Ithoh/OpenRucheDLCB/README.md

# OpenRucheDLCB

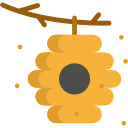
[picture p1: Ressources/hive.png]
GitHub Logo


Github participatif du projet open ruche polytech sorbonne Ei-2i-4

### **Arduino code depedencies :**

* Arduino Low Power
* Arduino SigFox for MKRFox1200
* RTCZero
* Adafruit Unified Sensor
* DallasTemperature
* DHT Sensor library
* OneWire
