Ithoh/OpenRucheDLCB/Documentation/Project_Connected_Beehive_v2.pptx

## Connected Beehive Project

DELAS Léo – DOS SANTOS Damien – DURAND DE GEVIGNEY Basile – TAN Caroline
EI2I 4 II

## Sommaire

- I - PCB Final
- II – Consommation du système
- III – Sigfox et Ubidots
- IV – Résultats
- V - Installation
- VI – Conclusion

## I - Diagramme Synoptique

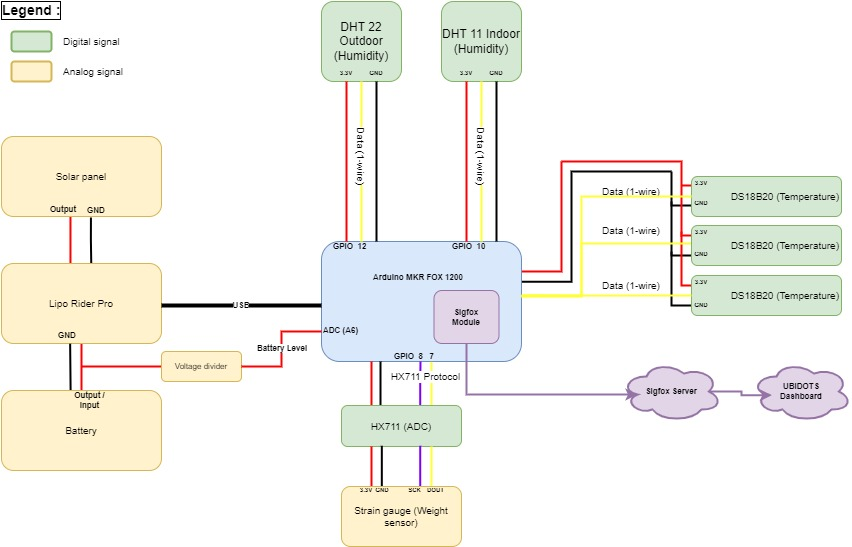
[picture p2: figure]

## I - PCB Final

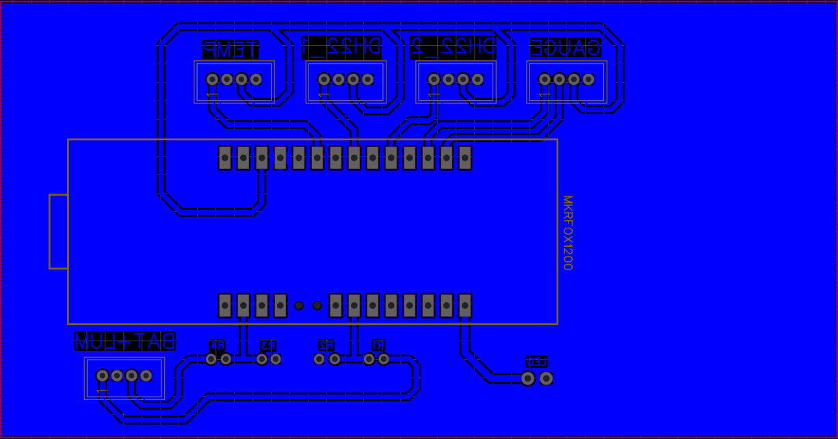
[picture p3: figure]

## II - Consommation du système

Mesures avec l’outil OTII

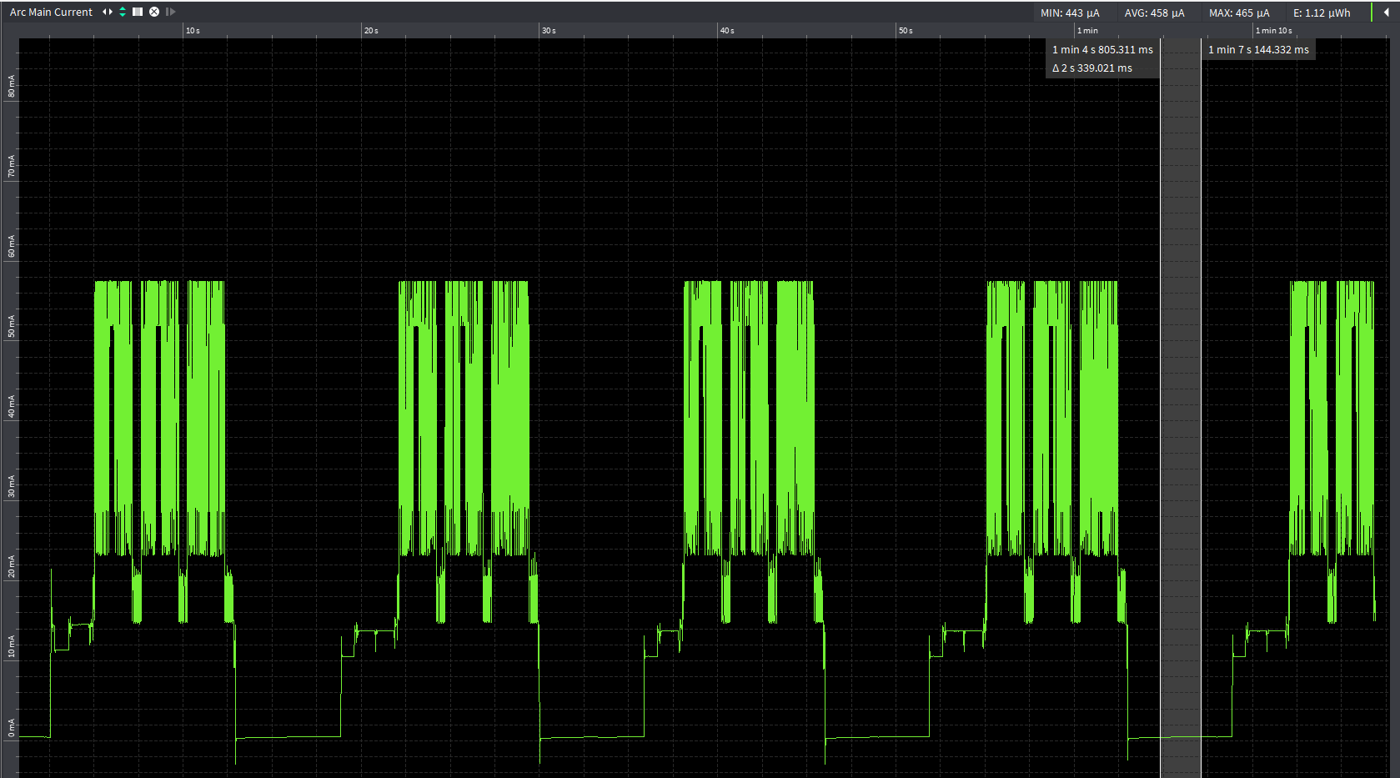
[picture p4: figure]

Consommation en mode low-power au repos : 450µA
Capacité total de la batterie
- 4.41 Wh

## II - Consommation du système

Mesures avec l’outil OTII

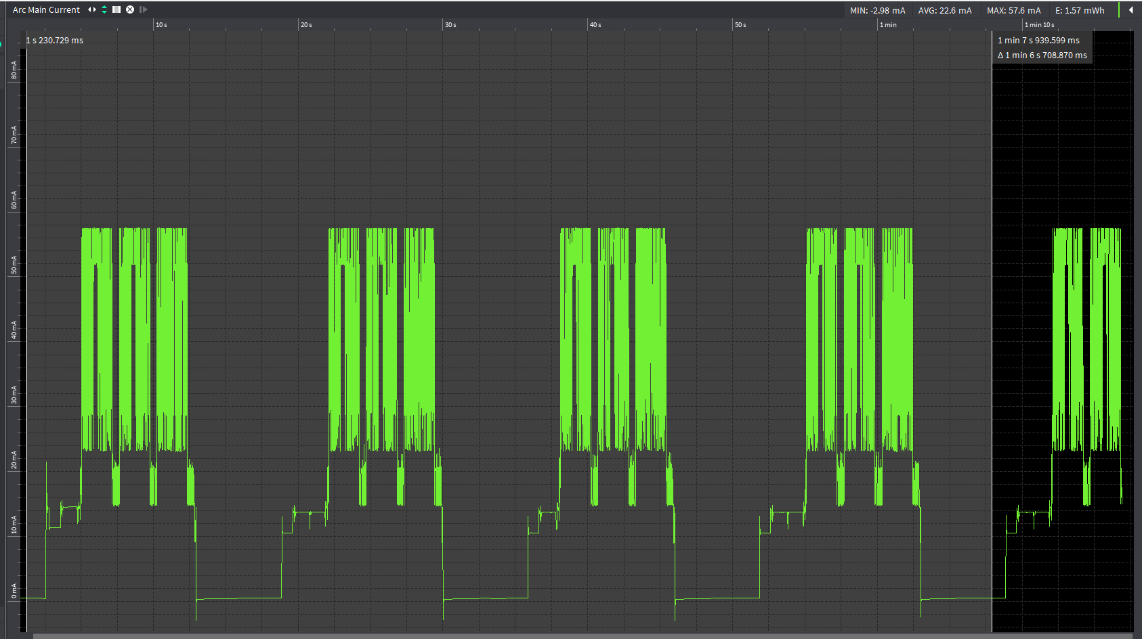
[picture p5: figure]

395 μWh / Message
138 messages par jour
450 µA au repos
Capacité total de la batterie
- 4.41 Wh
Autonomie estimée a environ 38 jours,
améliorée grâce au panneau solaire

## III - Décomposition des bits pour l’envoi sur Backend Sigfox

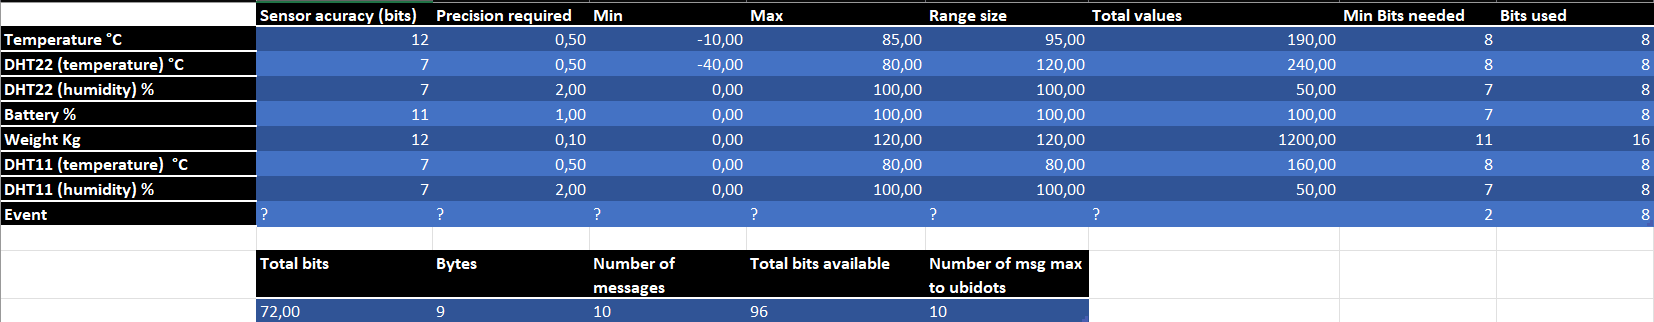
[picture p6: figure]

## III - Sigfox & Ubidots

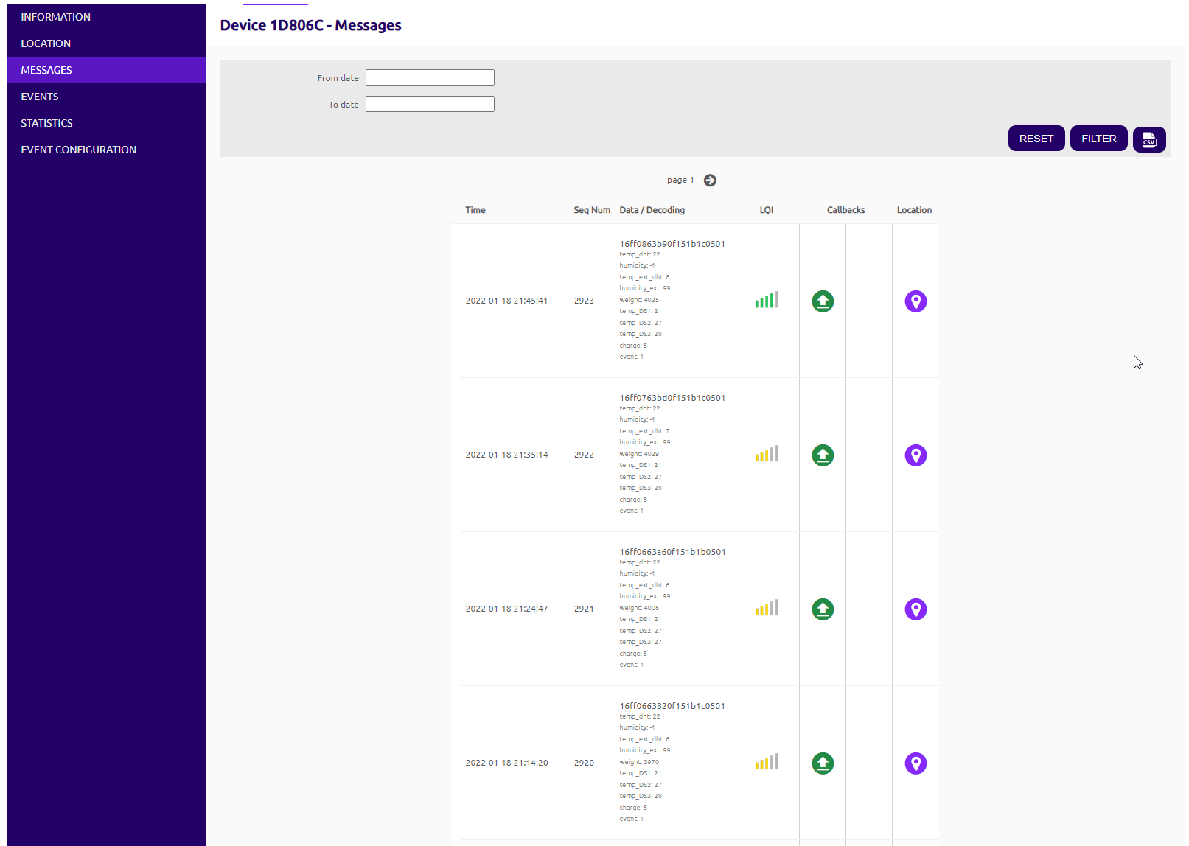
[picture p7: figure]

Sigfox backend :

https://backend.sigfox.com/auth/login

## III - Sigfox & Ubidots

Dashboard Ubidots

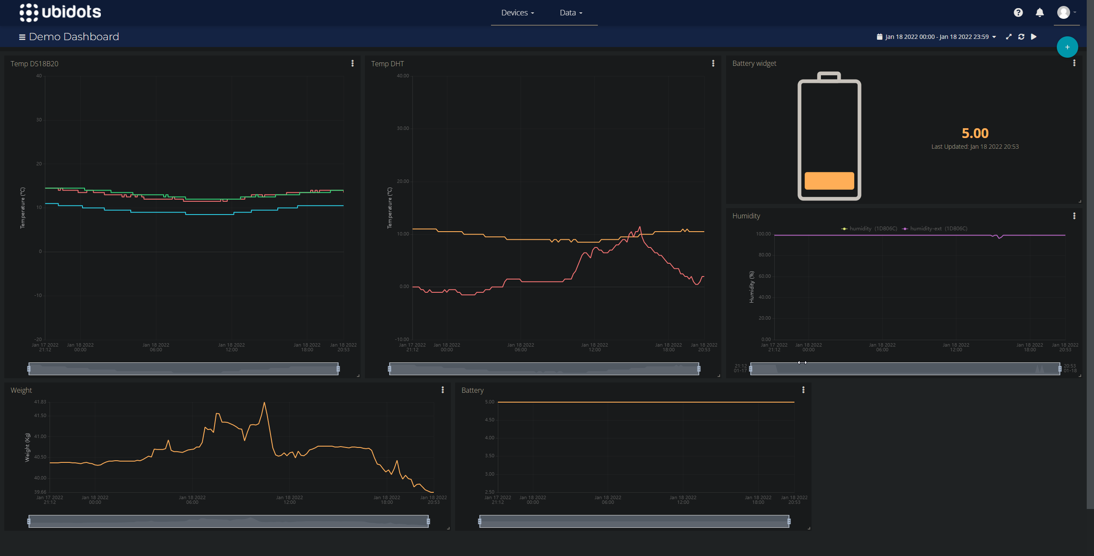
[picture p8: figure]

https://industrial.ubidots.com/accounts/signin/

## IV - Résultats

Quelques photos du projet

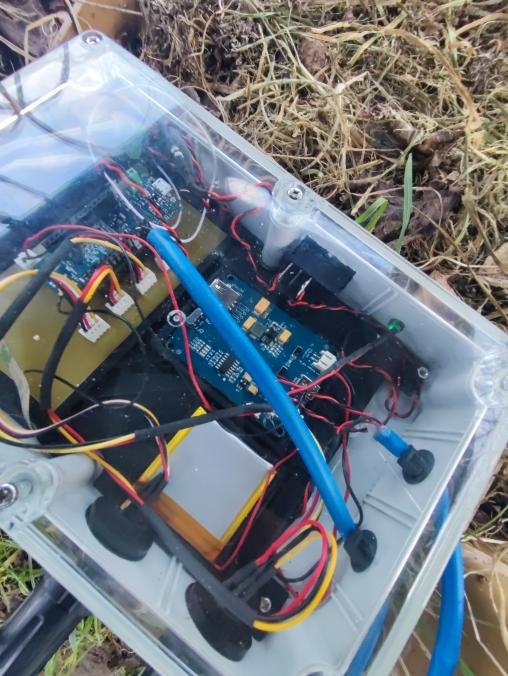
[picture p9: figure]
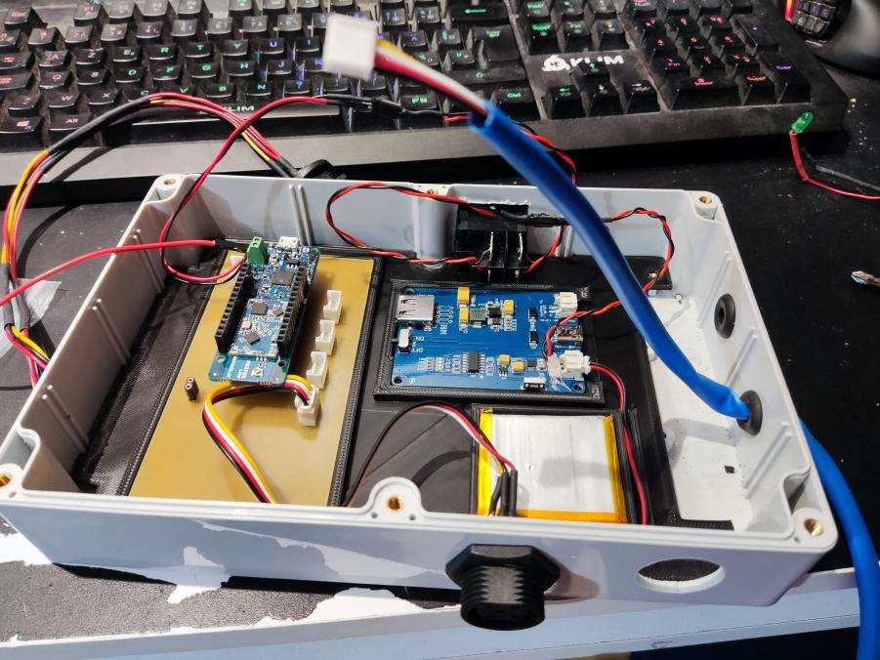
[picture p10: figure]

## V - Installation

Quelques photos de l’installation du projet

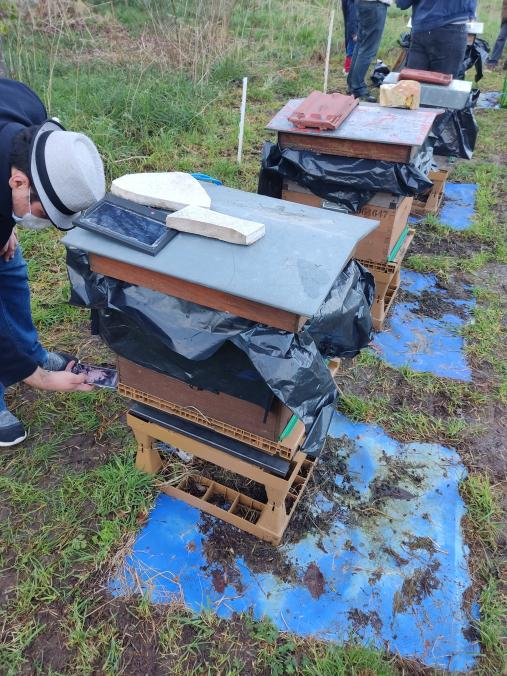
[picture p11: figure]
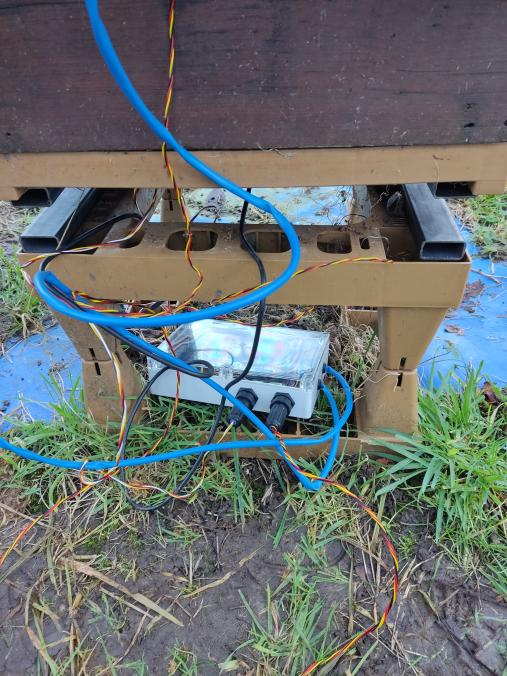
[picture p12: figure]
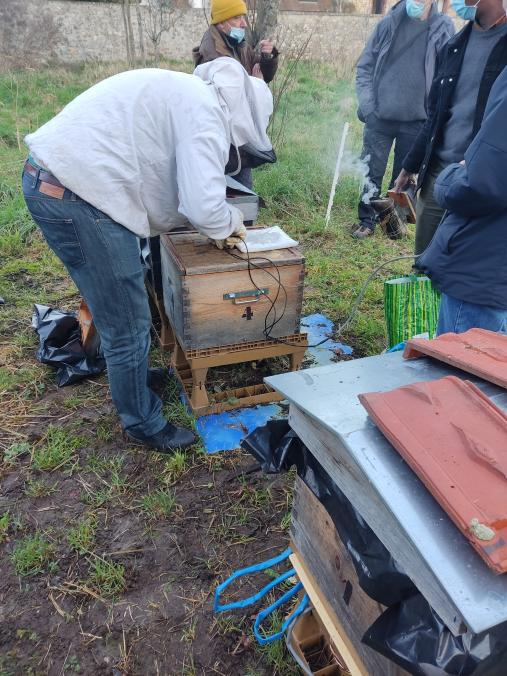
[picture p13: figure]

## Slide 12

V - Installation

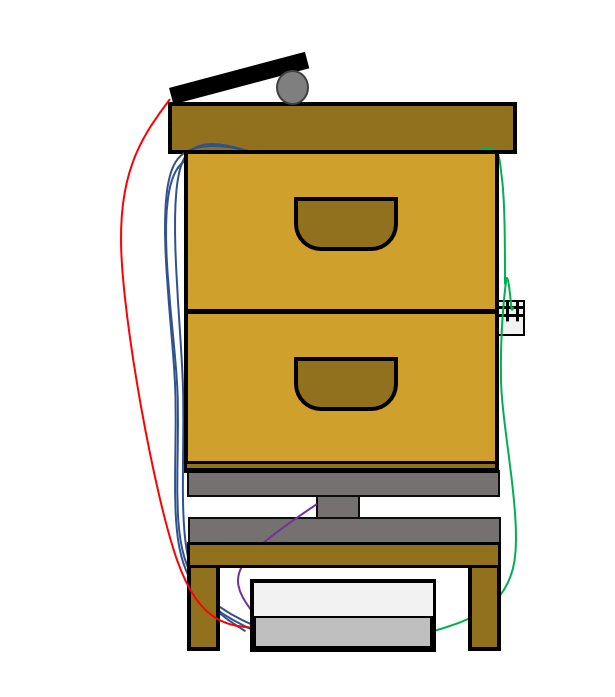
[picture p14: figure]
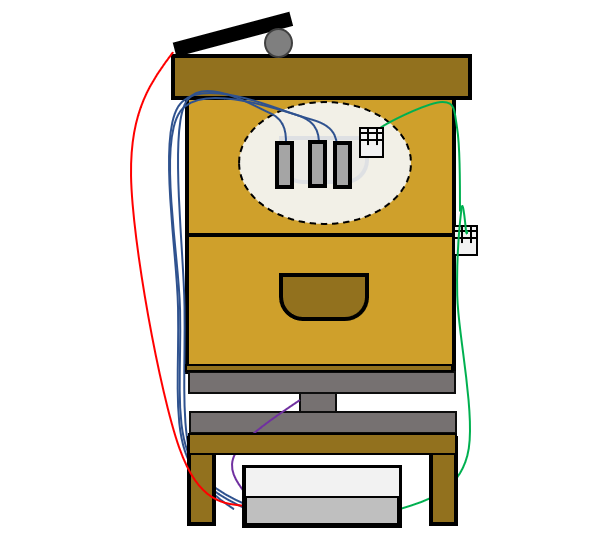
[picture p15: figure]
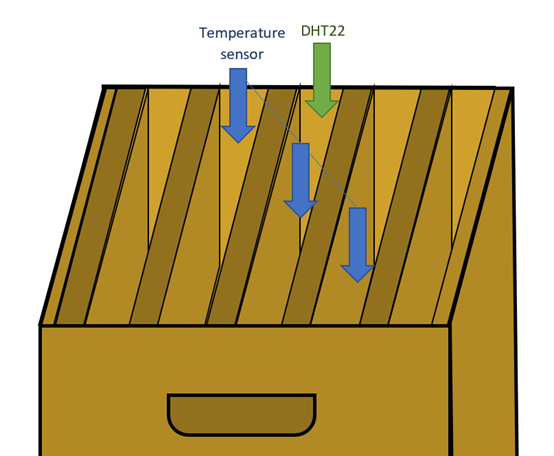
[picture p16: figure]

## VI - Conclusion

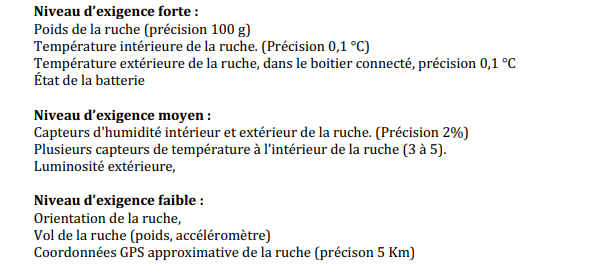
[picture p17: figure]

(Mais on a la localisation Sigfox)

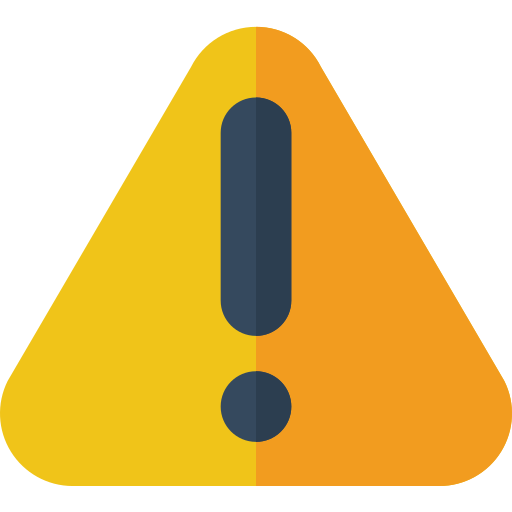
[picture p18: figure]
Warning free icon
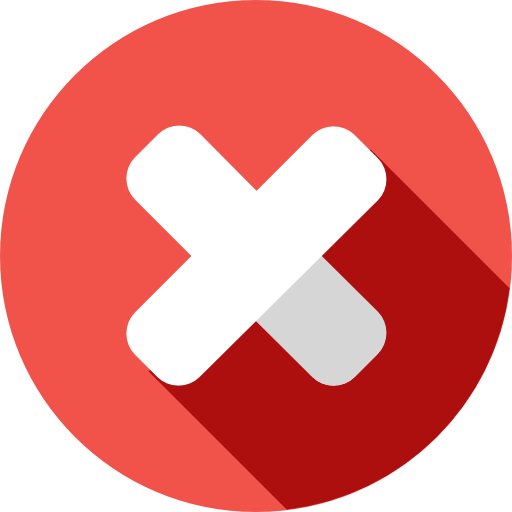
[picture p19: figure]
Cancel free icon

## Merci
