Ithoh/OpenRucheDLCB/Documentation/Fonctionel.png

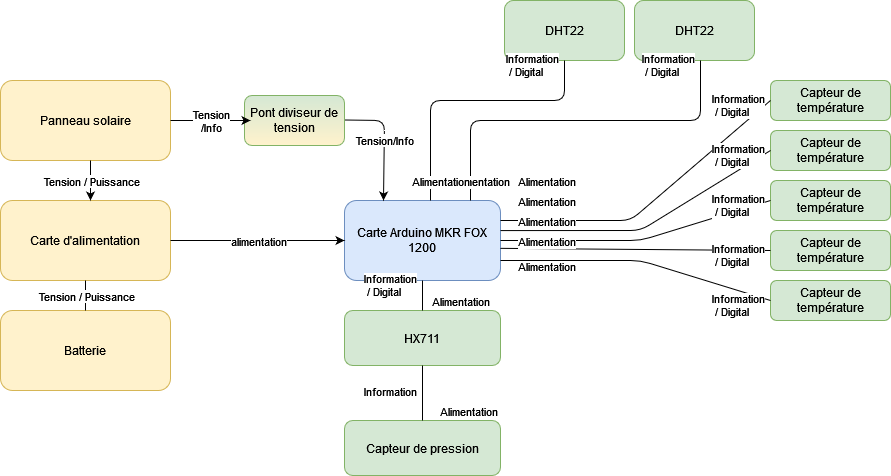
Documentation/Fonctionel.png
