Ithoh/OpenRucheDLCB/Documentation/Information.drawio.png

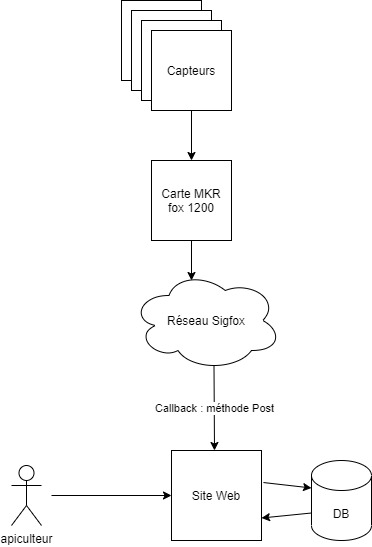
Documentation/Information.drawio.png
