Ithoh/OpenRucheDLCB/Ressources/PCB_Schematic/Gerber_OpenRuchPCB_ALIM_2022-01-18/How-to-order-PCB.txt

How to Order PCB

Please refer to:
https://docs.easyeda.com/en/PCB/Order-PCB
