Ithoh/OpenRucheDLCB/Codes/Test_Capteurs/DHT22/DHT22_Test/DHT22_Test.ino

// Example testing sketch for various DHT humidity/temperature sensors
// Written by ladyada, public domain

// REQUIRES the following Arduino libraries:
// - DHT Sensor Library: https://github.com/adafruit/DHT-sensor-library
// - Adafruit Unified Sensor Lib: https://github.com/adafruit/Adafruit_Sensor

#include "DHT.h"
#include <SigFox.h>

#define DHTPIN 10 // Digital pin connected to the DHT sensor
// Feather HUZZAH ESP8266 note: use pins 3, 4, 5, 12, 13 or 14 --
// Pin 15 can work but DHT must be disconnected during program upload.

// Uncomment whatever type you're using!
//#define DHTTYPE DHT11 // DHT 11
#define DHTTYPE DHT22   // DHT 22  (AM2302), AM2321
//#define DHTTYPE DHT21   // DHT 21 (AM2301)

// Connect pin 1 (on the left) of the sensor to +5V
// NOTE: If using a board with 3.3V logic like an Arduino Due connect pin 1
// to 3.3V instead of 5V!
// Connect pin 2 of the sensor to whatever your DHTPIN is
// Connect pin 3 (on the right) of the sensor to GROUND (if your sensor has 3 pins)
// Connect pin 4 (on the right) of the sensor to GROUND and leave the pin 3 EMPTY (if your sensor has 4 pins)
// Connect a 10K resistor from pin 2 (data) to pin 1 (power) of the sensor

// Initialize DHT sensor.
// Note that older versions of this library took an optional third parameter to
// tweak the timings for faster processors.  This parameter is no longer needed
// as the current DHT reading algorithm adjusts itself to work on faster procs.
DHT dht(DHTPIN, DHTTYPE);

typedef struct __attribute__((packed)) sigfox_message
{
  int16_t temp;
  int16_t humidity;
  
} SigfoxMessage;

// stub for message which will be sent

SigfoxMessage msg;

// =================== UTILITIES ===================
void reboot()
{
  NVIC_SystemReset();
  while (1)
    ;
}

void setup()
{
  if (!SigFox.begin())
  {
    Serial.println("SigFox error, rebooting");
    reboot();
  }
  
  Serial.begin(9600);
  while (!Serial)
    ;

  Serial.println(F("DHTxx test!"));
  dht.begin();

  delay(100); // Wait at least 30ms after first configuration
  // Enable debug prints and LED indication
  SigFox.debug();

  // Clears all pending interrupts
  SigFox.status();
  delay(1); 
}

void envoi(SigfoxMessage message)
{
  SigFox.begin();
  SigFox.status();
  delay(1);
  SigFox.beginPacket();
  SigFox.write((uint8_t *)&message, sizeof(SigfoxMessage));
  Serial.print("Status : ");
  Serial.println(SigFox.endPacket());
  SigFox.end();
}
void loop()
{
  // Reading temperature or humidity takes about 250 milliseconds!
  // Sensor readings may also be up to 2 seconds 'old' (its a very slow sensor)
  float h = dht.readHumidity();
  // Read temperature as Celsius (the default)
  float t = dht.readTemperature();

  // Check if any reads failed and exit early (to try again).
  if (isnan(h) || isnan(t))
  {
    Serial.println(F("Failed to read from DHT sensor!"));
    return;
  }

  Serial.print(F("Humidity: "));
  Serial.print(h);
  Serial.print(F("%  Temperature: "));
  Serial.print(t);
  Serial.println(F("°C "));

  msg.temp = int16_t(t * 100);
  msg.humidity = int16_t(h * 100);
  //envoi(msg);

  // Wait a few seconds between measurements.
  delay(1000);
}
