Ithoh/OpenRucheDLCB/Codes/Test_Capteurs/DS18B20/test_one_wire/test_one_wire.ino

// Include the libraries we need
#include <OneWire.h>
#include <DallasTemperature.h>

// Data wire is plugged into port 2 on the Arduino
#define ONE_WIRE_BUS 10
#define TEMPERATURE_PRECISION 9

// Setup a oneWire instance to communicate with any OneWire devices (not just Maxim/Dallas temperature ICs)
OneWire oneWire(ONE_WIRE_BUS);

// Pass our oneWire reference to Dallas Temperature.
DallasTemperature sensors(&oneWire);

// arrays to hold device addresses
DeviceAddress Thermometer1, Thermometer2, Thermometer3;

void setup(void)
{
  // start serial port
  Serial.begin(9600);

  // Start up the library
  sensors.begin();

  // locate devices on the bus
  Serial.print("Locating devices...");
  Serial.print("Found ");
  Serial.print(sensors.getDeviceCount(), DEC);
  Serial.println(" devices.");

  // report parasite power requirements
  Serial.print("Parasite power is: ");
  if (sensors.isParasitePowerMode()) Serial.println("ON");
  else Serial.println("OFF");

  if (!sensors.getAddress(Thermometer1, 0)) Serial.println("Unable to find address for Device 0");
  if (!sensors.getAddress(Thermometer2, 1)) Serial.println("Unable to find address for Device 1");
  if (!sensors.getAddress(Thermometer3, 1)) Serial.println("Unable to find address for Device 2");


  // show the addresses we found on the bus
  Serial.print("Device 0 Address: ");
  printAddress(Thermometer1);
  Serial.println();

  Serial.print("Device 1 Address: ");
  printAddress(Thermometer2);
  Serial.println();

   Serial.print("Device 2 Address: ");
  printAddress(Thermometer2);
  Serial.println();

  // set the resolution to 9 bit per device
  sensors.setResolution(Thermometer1, TEMPERATURE_PRECISION);
  sensors.setResolution(Thermometer2, TEMPERATURE_PRECISION);
  sensors.setResolution(Thermometer3, TEMPERATURE_PRECISION);

  Serial.print("Device 0 Resolution: ");
  Serial.print(sensors.getResolution(Thermometer1), DEC);
  Serial.println();

  Serial.print("Device 1 Resolution: ");
  Serial.print(sensors.getResolution(Thermometer2), DEC);
  Serial.println();

  Serial.print("Device 2 Resolution: ");
  Serial.print(sensors.getResolution(Thermometer3), DEC);
  Serial.println();
}

// function to print a device address
void printAddress(DeviceAddress deviceAddress)
{
  for (uint8_t i = 0; i < 8; i++)
  {
    // zero pad the address if necessary
    if (deviceAddress[i] < 16) Serial.print("0");
    Serial.print(deviceAddress[i], HEX);
  }
}

// function to print the temperature for a device
void printTemperature(DeviceAddress deviceAddress)
{
  float tempC = sensors.getTempC(deviceAddress);
  if(tempC == DEVICE_DISCONNECTED_C) 
  {
    Serial.println("Error: Could not read temperature data");
    return;
  }
  Serial.print("Temp C: ");
  Serial.print(tempC);
  Serial.print(" Temp F: ");
  Serial.print(DallasTemperature::toFahrenheit(tempC));
}

// function to print a device's resolution
void printResolution(DeviceAddress deviceAddress)
{
  Serial.print("Resolution: ");
  Serial.print(sensors.getResolution(deviceAddress));
  Serial.println();
}

// main function to print information about a device
void printData(DeviceAddress deviceAddress)
{
  Serial.print("Device Address: ");
  printAddress(deviceAddress);
  Serial.print(" ");
  printTemperature(deviceAddress);
  Serial.println();
}

/*
   Main function, calls the temperatures in a loop.
*/
void loop(void)
{
  // call sensors.requestTemperatures() to issue a global temperature
  // request to all devices on the bus
  Serial.print("Requesting temperatures...");
  sensors.requestTemperatures();
  Serial.println("DONE");

  // print the device information
  printData(Thermometer1);
  printData(Thermometer2);
  printData(Thermometer3);
}
