Ithoh/OpenRucheDLCB/(commit log)

2021-09-15 Ajout des PDF
2021-09-15 schéma fonctionnel V1 ✨
2021-09-29 Version corrigée de la v1
    Correction du texte
2021-10-06 Added sigfox module in the schematic
2021-10-06 Added legend to the schematic and modified some colors
2021-10-06 Ajout du code source de la lecture de tension
2021-10-06 Code niveau de batterie
2021-10-06 😒 travail de Damien + mien
2021-10-06 Correction du code du DHT22+envoi sigfox de plusieurs messages
    [DHT22_Test.ino]
2021-10-06 Correction pour l'envoi du plusieurs messages
    [Sigfox_test.ino]
2021-10-06 Ajout de la lecture de plusieurs capteurs
2021-10-20 Correction + ajout de la structure du programme principale et d'un premier test
    [Lecture_tension.ino]
2021-10-26 Ajout de la fonction LowPower.sleep()
2021-10-26 Présentation Powerpoint
2021-10-26 Modification du Powerpoint
2021-11-24 PCB Updated + Schematic file \_|@_@|_/
    [Gerber_BoardOutline.GKO, Gerber_BottomLayer.GBL, Gerber_BottomSolderMaskLayer.GBS, Gerber_Drill_PTH.DRL, Gerber_TopLayer.GTL, Gerber_TopSilkLayer.GTO, Gerber_TopSolderMaskLayer.GTS]
2022-01-14 Reorganisation des fichiers du projet
2022-01-18 Updated PCB Files
2022-01-18 Added gerber files (generated with EASY EDA)
    [Gerber_BoardOutline.GKO, Gerber_BottomLayer.GBL, Gerber_BottomSolderMaskLayer.GBS, Gerber_Drill_PTH.DRL, Gerber_TopLayer.GTL, Gerber_TopSilkLayer.GTO, Gerber_TopSolderMaskLayer.GTS]
2022-01-23 Document de test
